piotrpodlaski/NixieClockPCB/nixie_adapter_pp/NX-SZP-IN3-v01.STEP

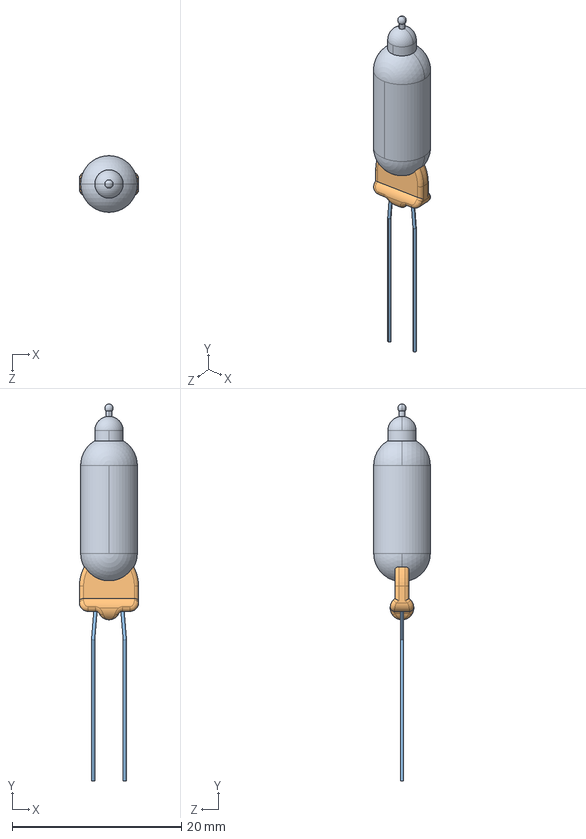
[picture p1: CAD file, 2023-03-22]
nixie_adapter_pp/NX-SZP-IN3-v01.STEP
7.00 x 44.6 x 6.70 mm
NX-SZP-IN3-01-v01
NX-SZP-IN3-02-v01 x 2
NX-SZP-IN3-03-v01
NX-SZP-IN3-04-v01
NX-SZP-IN3-05-v01
NX-SZP-IN3-06-v01
