piotrpodlaski/NixieClockPCB/nixie_controller/T491D107K020AT.step

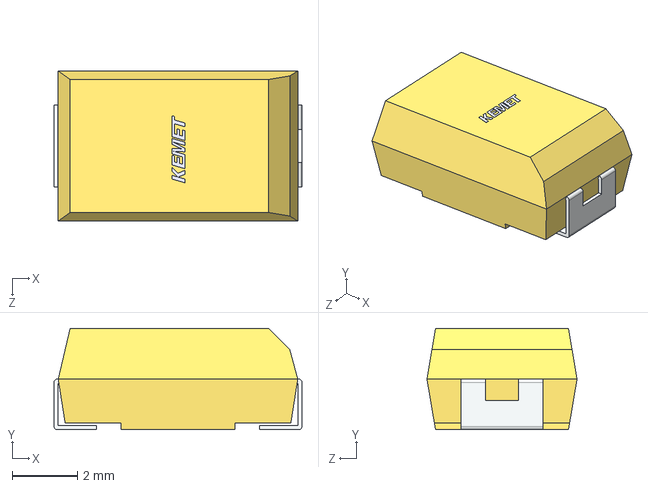
[picture p2: CAD file, 2023-03-22]
nixie_controller/T491D107K020AT.step
7.60 x 3.11 x 4.60 mm
