piotrpodlaski/NixieClockPCB/nixie_controller/SBC847BDW1T1G.step

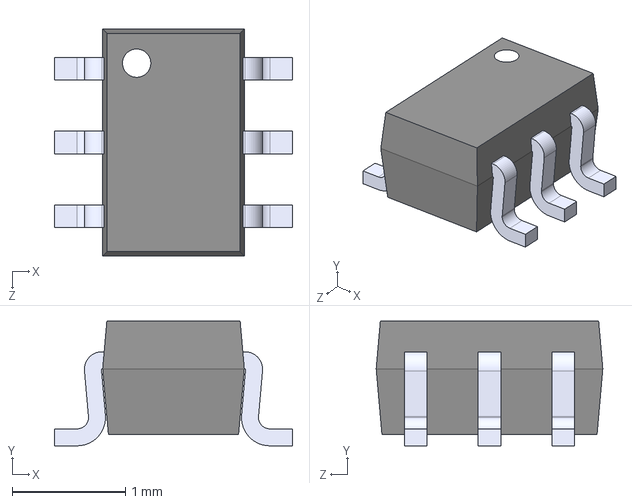
[picture p3: CAD file, 2023-03-22]
nixie_controller/SBC847BDW1T1G.step
2.10 x 1.10 x 2.00 mm
