piotrpodlaski/NixieClockPCB/nixie_controller/TYPE-C-31-M-12.step

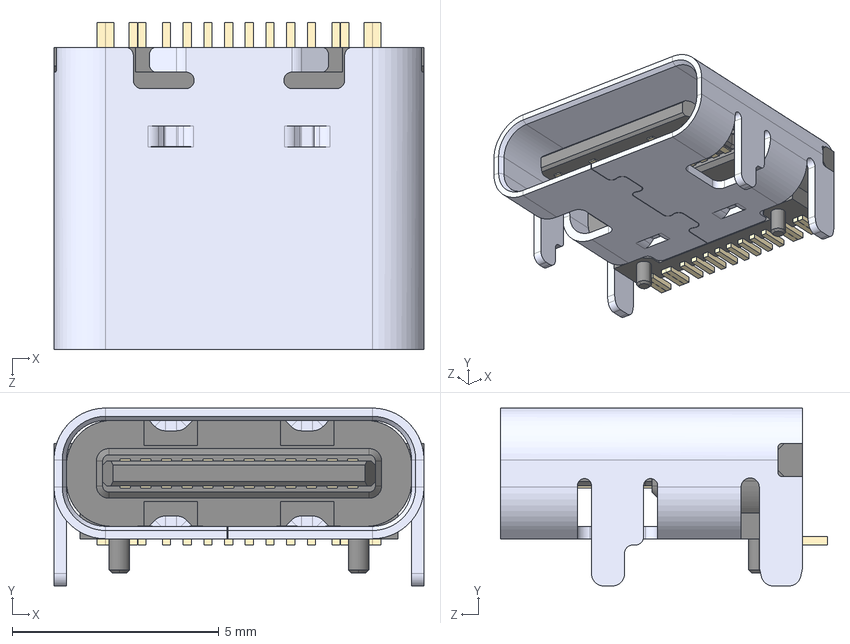
[picture p4: CAD file, 2023-03-22]
nixie_controller/TYPE-C-31-M-12.step
8.94 x 4.30 x 7.90 mm
