piotrpodlaski/NixieClockPCB/nixie_controller/SKRKAHE020--3DModel-STEP-56544.STEP

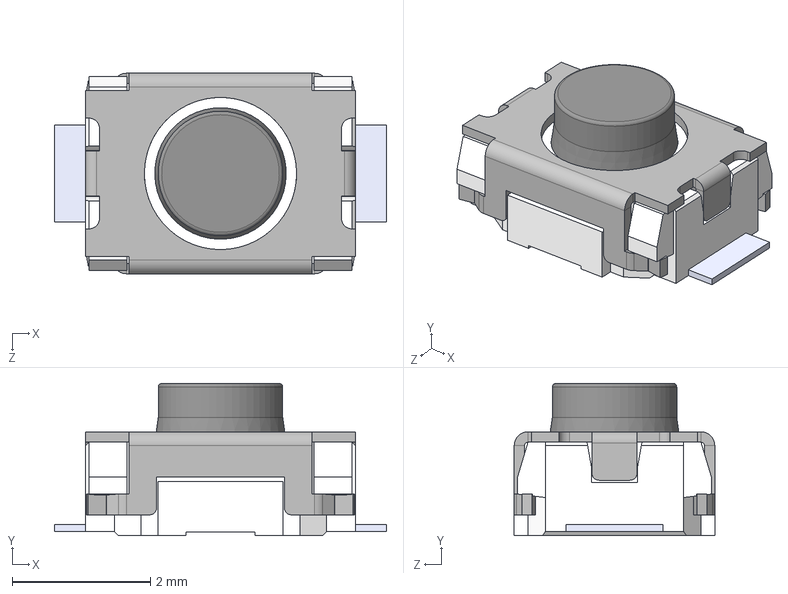
[picture p5: CAD file, 2023-03-22]
nixie_controller/SKRKAHE020--3DModel-STEP-56544.STEP
4.80 x 2.20 x 2.90 mm
