piotrpodlaski/NixieClockPCB/nixie_controller/TPIC6B595DW.step

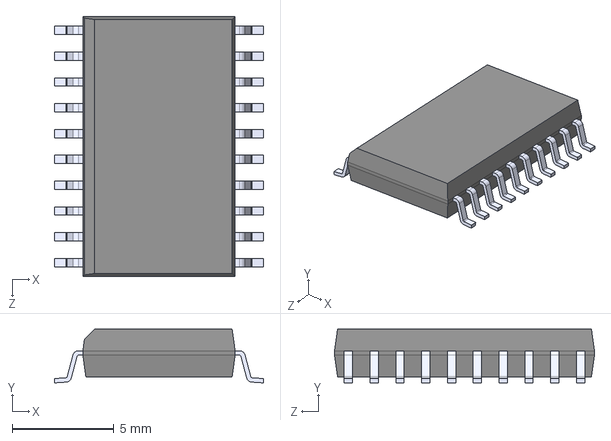
[picture p6: CAD file, 2023-03-22]
nixie_controller/TPIC6B595DW.step
10.3 x 2.65 x 12.8 mm
