piotrpodlaski/NixieClockPCB/nixie_controller/B82464G4153M000.STEP

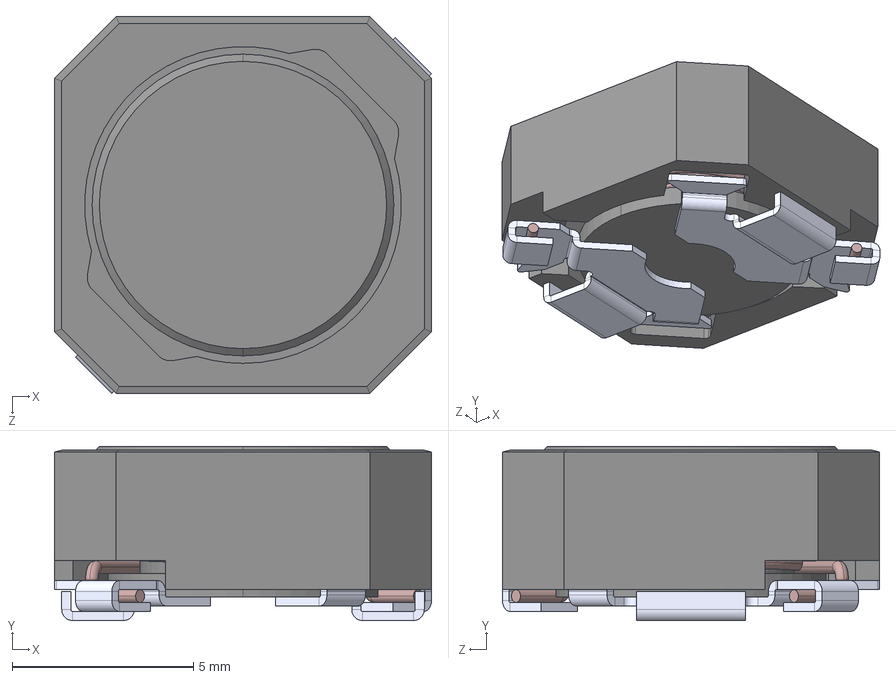
[picture p7: CAD file, 2023-03-22]
nixie_controller/B82464G4153M000.STEP
10.4 x 4.80 x 10.4 mm
