piotrpodlaski/NixieClockPCB/level_converter_fix.pdf

# Logic Level Converter Fix

# NixieClock

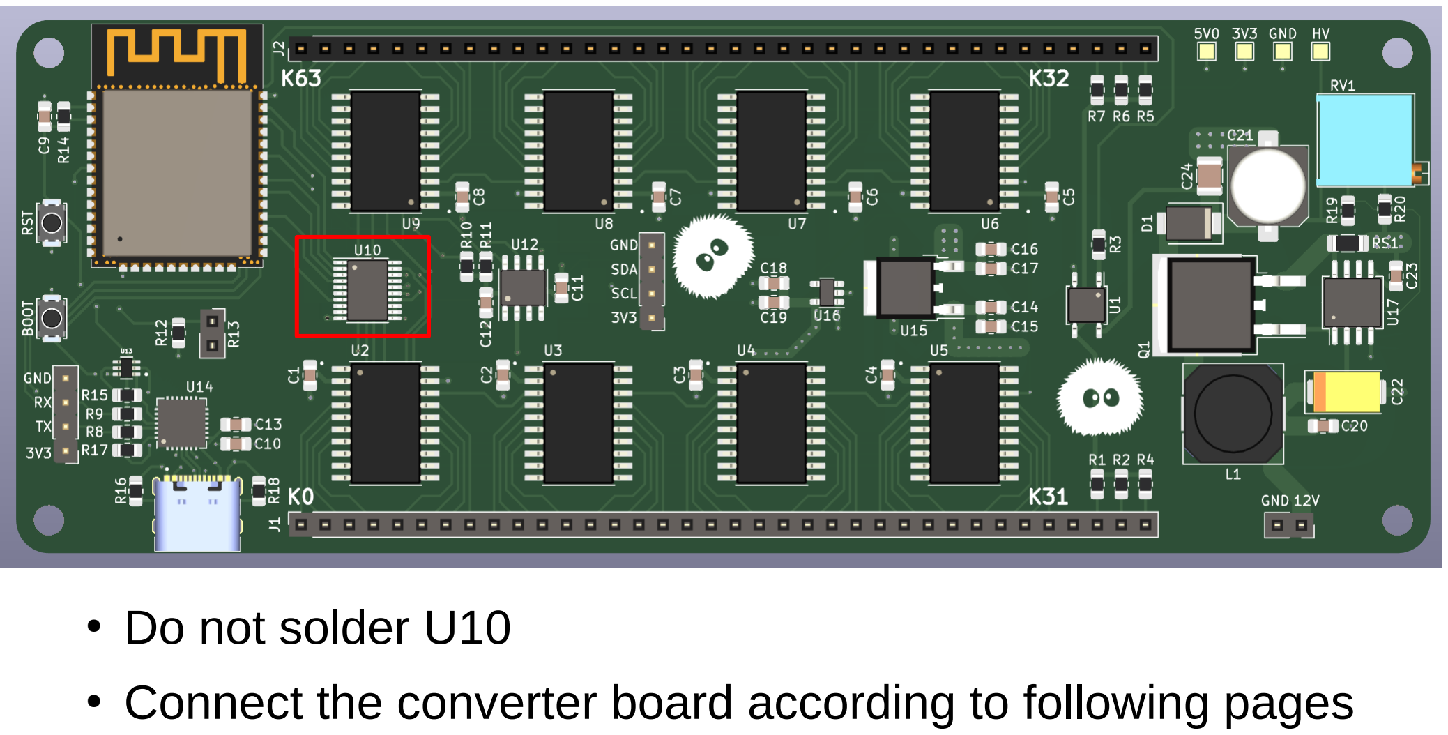
[picture p8: page 2]

## - Do not solder U10

## - Connect the converter board according to following pages

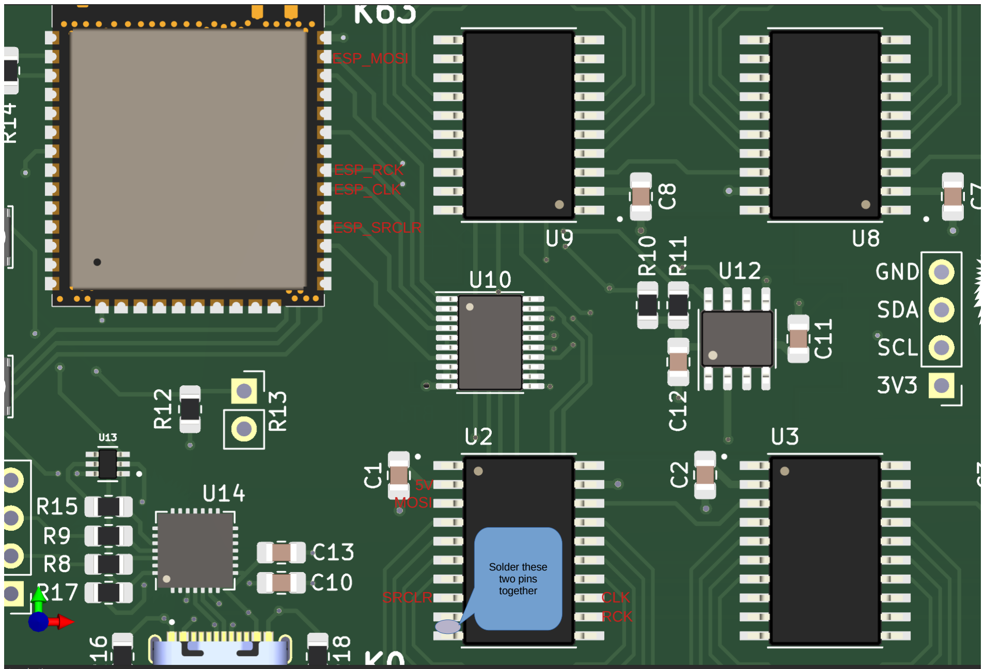
[picture p9: page 3]

ESP_MOSI

ESP_RCK

ESP_CLK

ESP_SRCLR

CLK

RCK

MOSI

SRCLR

5V

Solder these
two pins
together

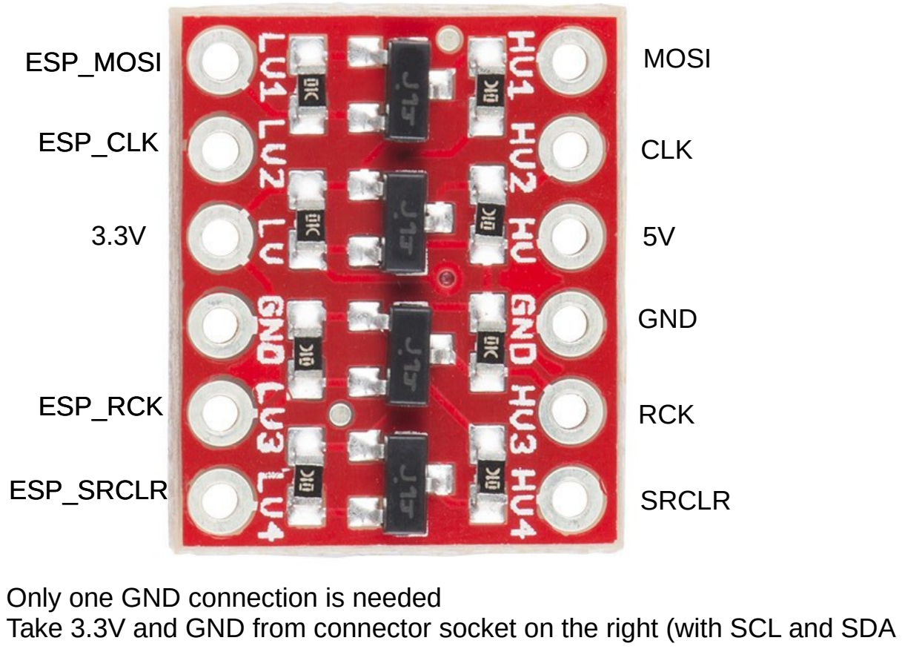
[picture p10: page 4]

ESP_MOSI

ESP_CLK

ESP_RCK

ESP_SRCLR

CLK

MOSI

RCK

SRCLR

3.3V

GND

Only one GND connection is needed
Take 3.3V and GND from connector socket on the right (with SCL and SDA

5V
