piotrpodlaski/NixieClockPCB/nixie_adapter_pp.pdf

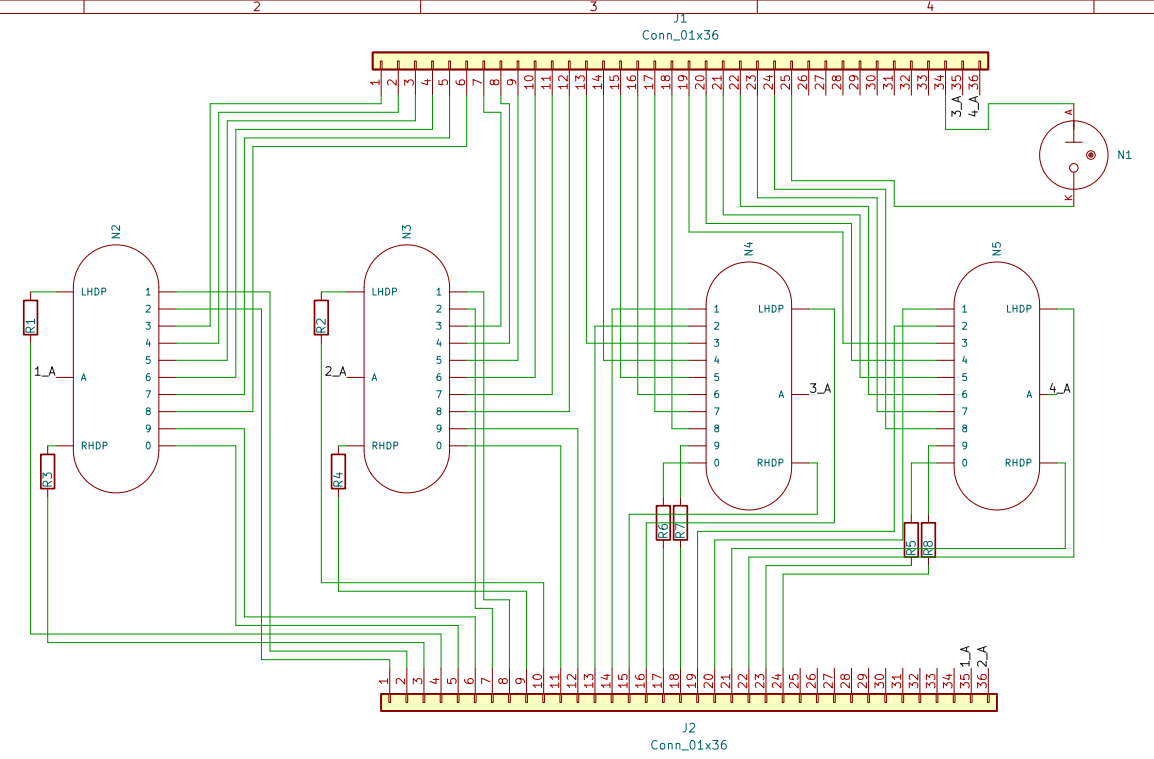
[picture p11: page 1]

Id: 1/1 Title: File: nixie_adapter_pp.kicad_sch Sheet: / R5
