piotrpodlaski/NixieClockPCB/nixie_controller.pdf

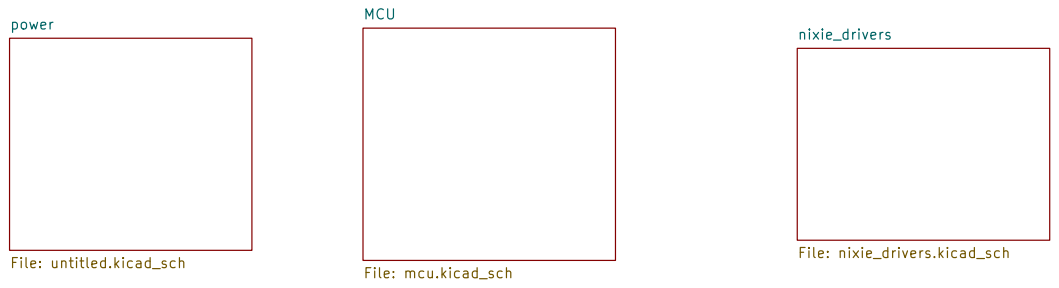
[picture p12: page 1]

Id: 1/4 Title: File: nixie_controller.kicad_sch Sheet: /

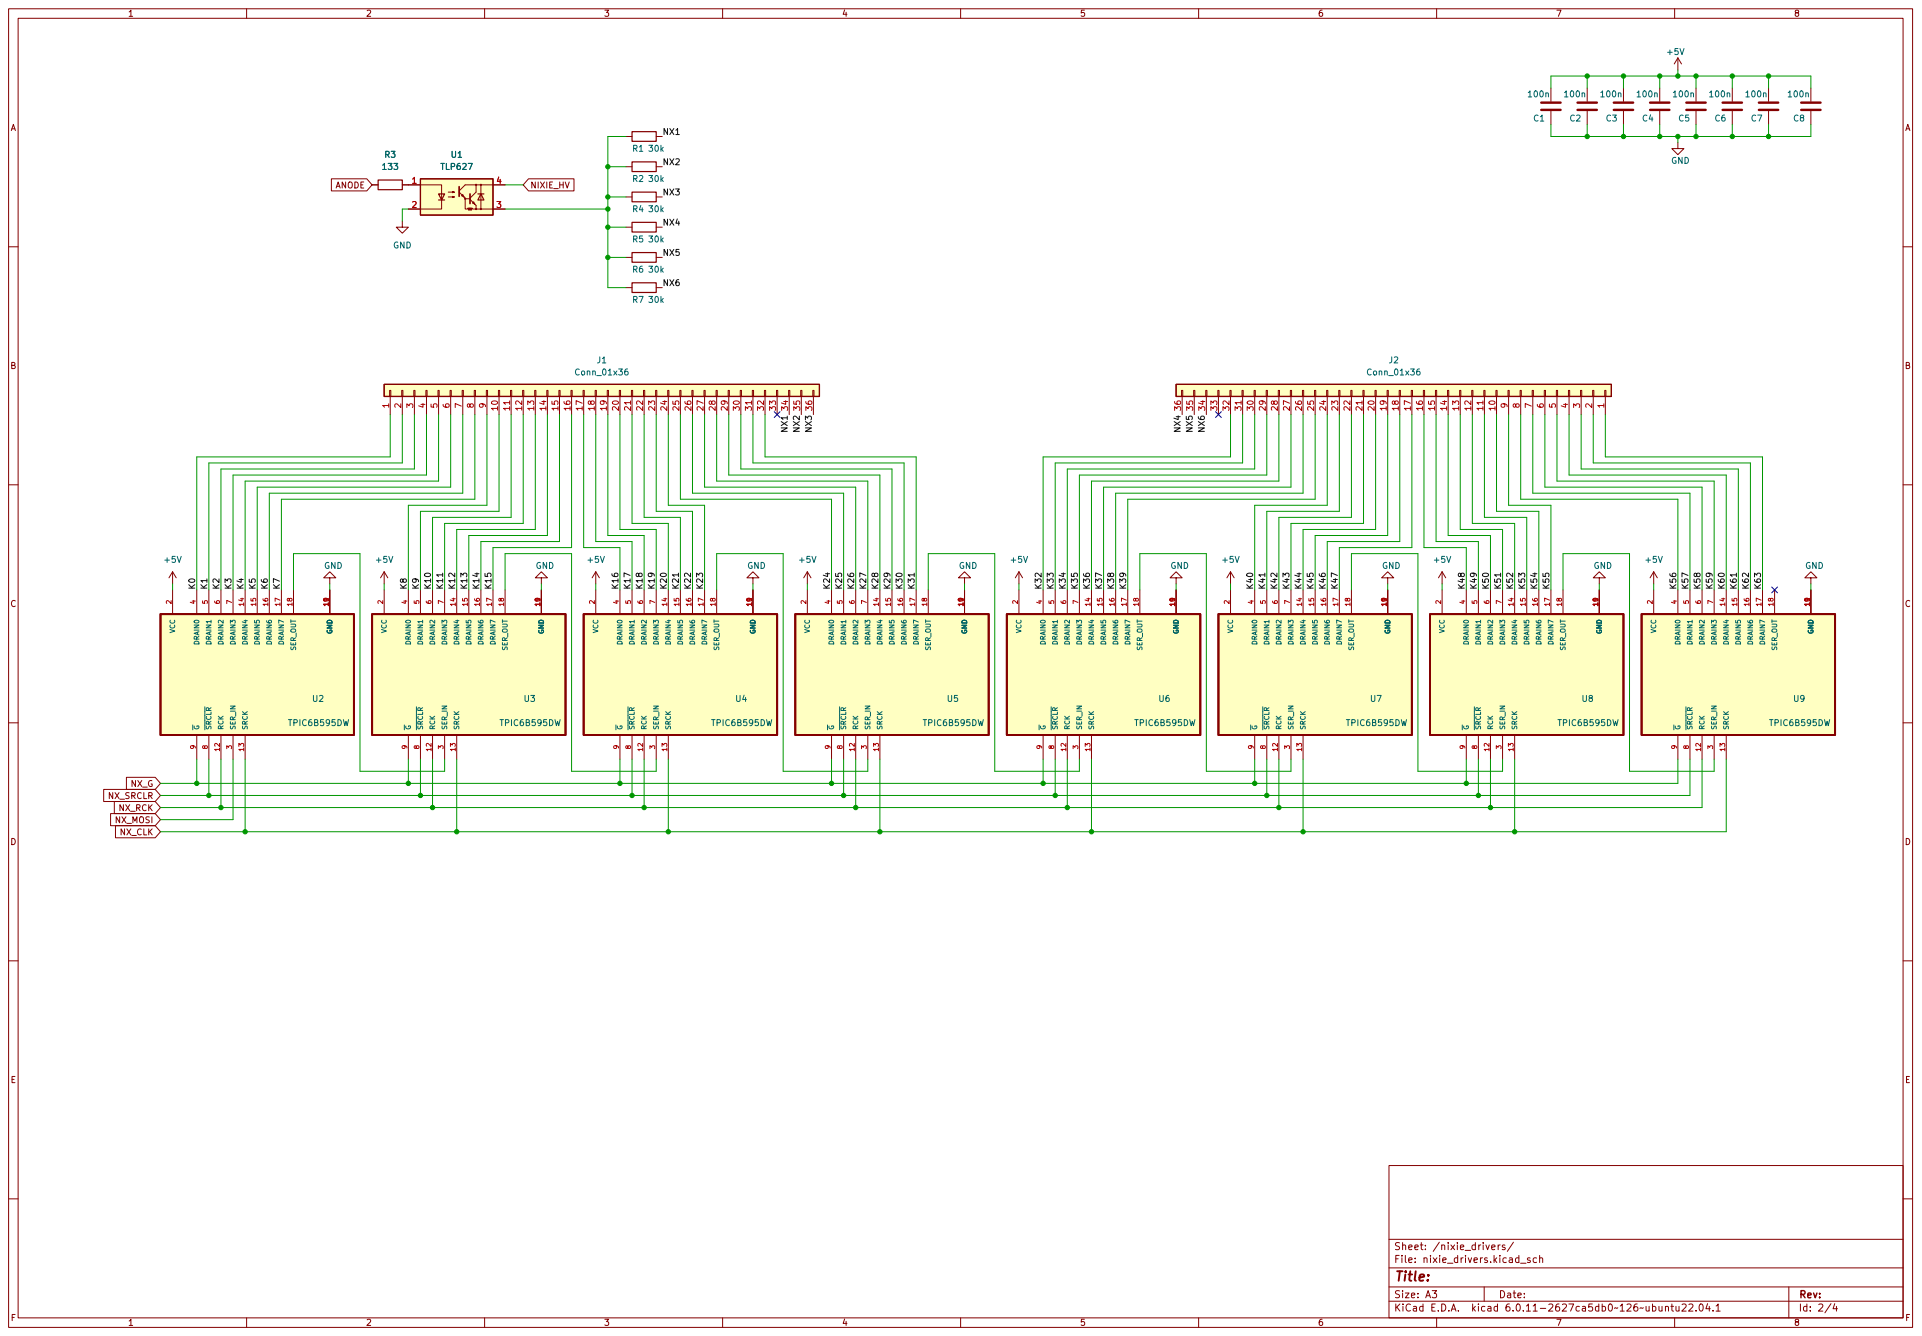
[picture p13: page 2]

7 ~{SRCLR} 8 ~{G} 9 U4 TPIC6B595DW GND 101 RCK 12 SRCK 13 DRAIN4 14 DRAIN5 15 DRAIN6 16 DRAIN7 17 SER_OUT 18 GND 19 VCC

Id: 2/4 Title: File: nixie_drivers.kicad_sch Sheet: /nixie_drivers/

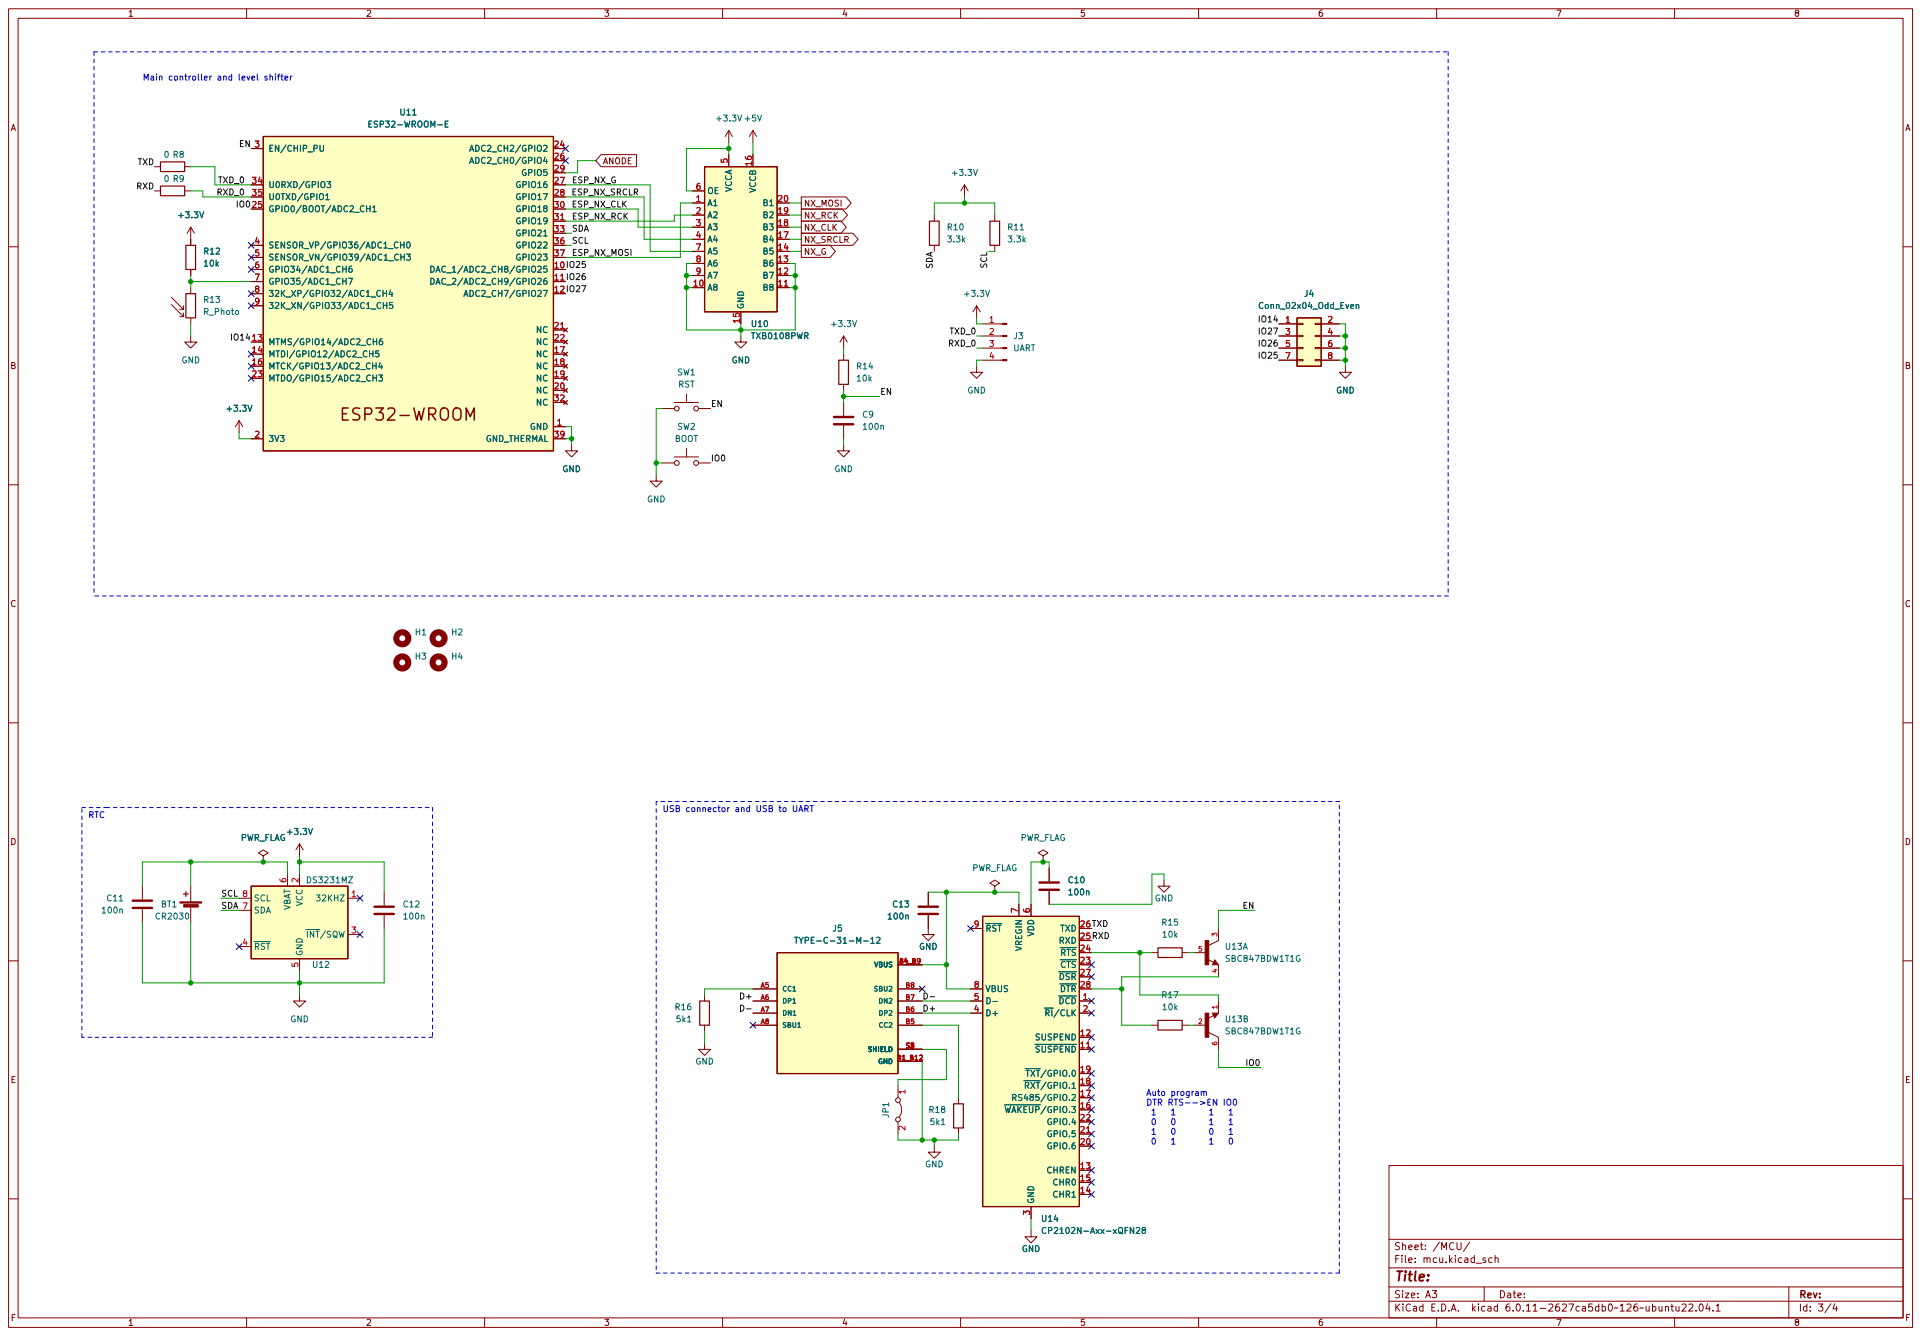
[picture p14: page 3]

Id: 3/4 Title: File: mcu.kicad_sch Sheet: /MCU/

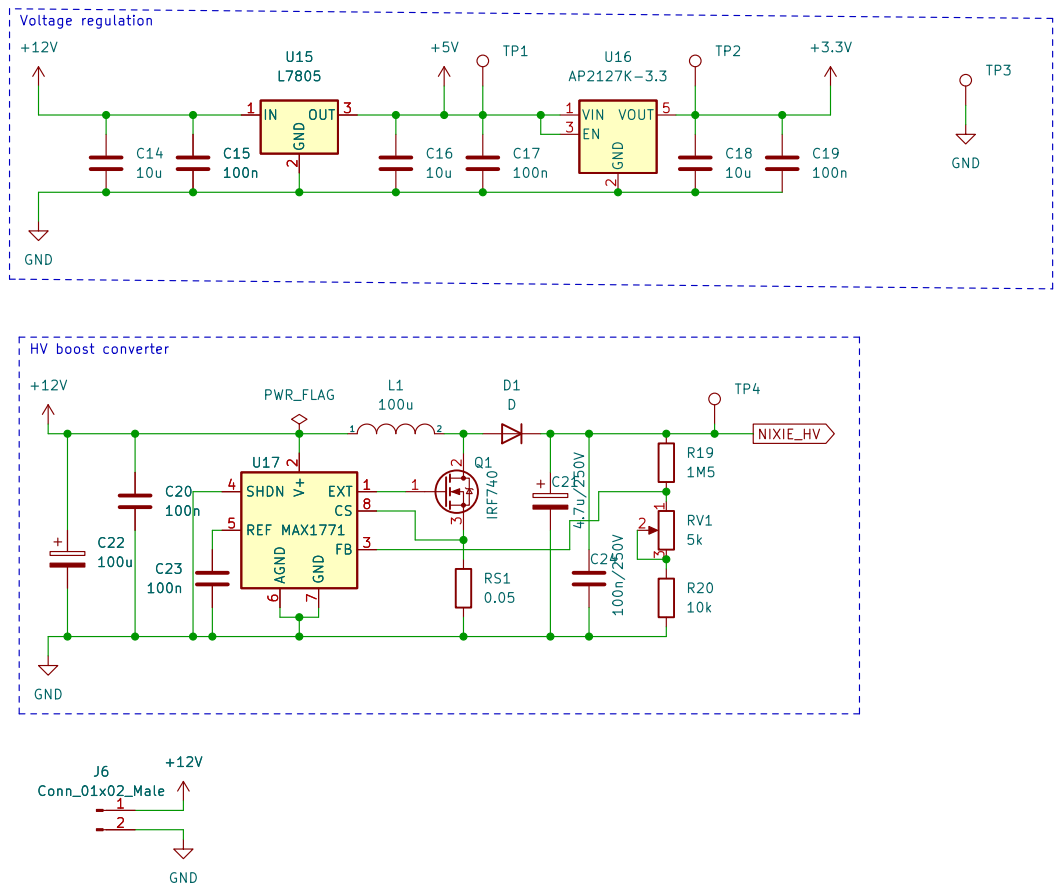
[picture p15: page 4]

Id: 4/4 Title: File: untitled.kicad_sch Sheet: /power/
