piotrpodlaski/NixieClockPCB/nixie_adapter_pp/nixie_adapter_pp.kicad_pcb

## KiCad design nixie_adapter_pp/nixie_adapter_pp.kicad_pcb (2023-03-22)

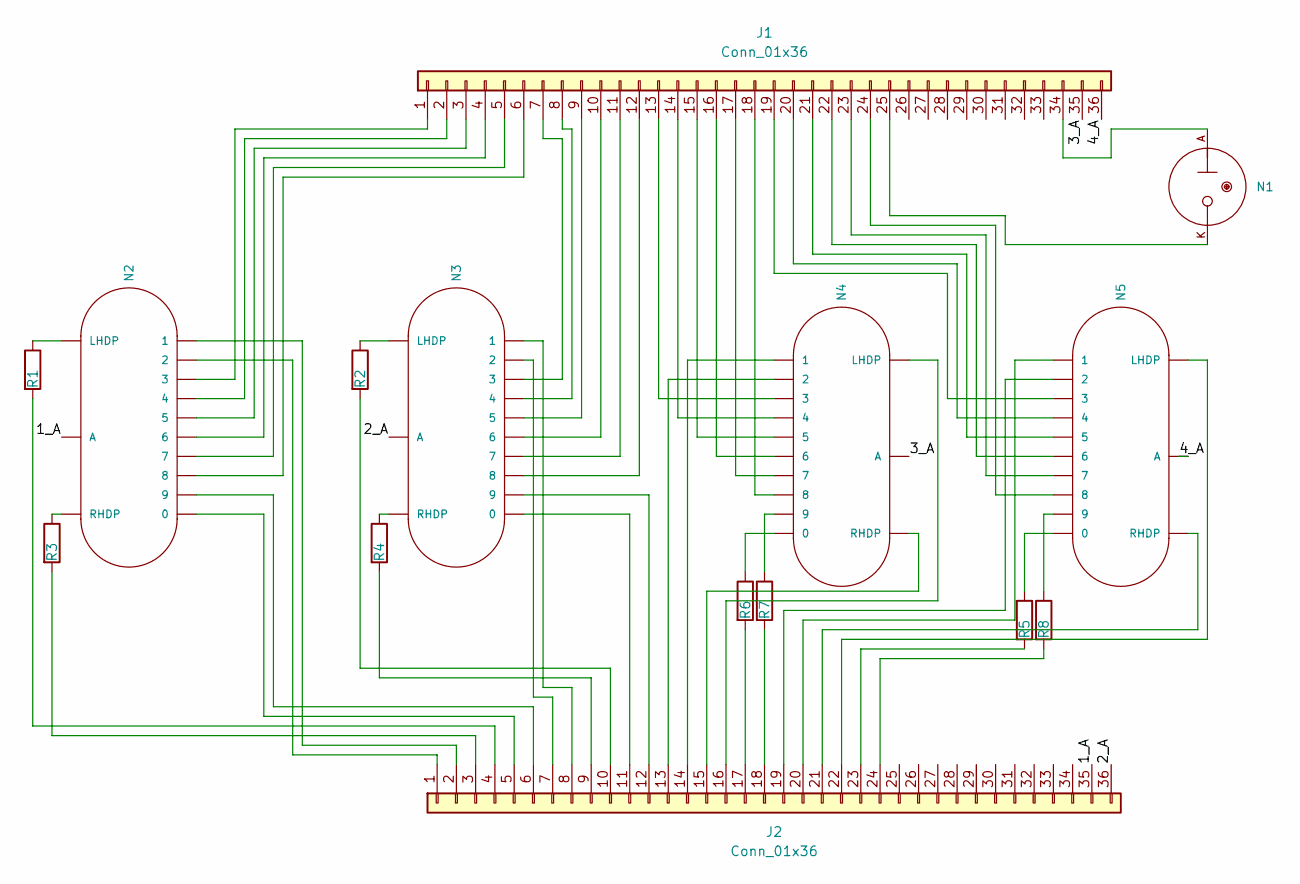
[picture p16: schematic nixie_adapter_pp.kicad_sch]

Parts:
J1, J2: Conn_01x36; PinHeader_1x36_P2.54mm_Vertical
N1: IN-3; nixies-us-IN-3
N2, N3, N4, N5: IN-14; nixies-us-IN-14
R1, R2, R3, R4, R5, R6, R7, R8: R; R_0805_2012Metric_Pad1.20x1.40mm_HandSolder

Connections:
/1_A: J2.35, N2.A
/2_A: J2.36, N3.A
/3_A: J1.35, N4.A
/4_A: J1.36, N5.A
unnamed: J1.1, N2.8 (3)
unnamed: J1.2, N2.7 (4)
unnamed: J1.3, N2.6 (5)
unnamed: J1.4, N2.5 (6)
unnamed: J1.5, N2.4 (7)
unnamed: J1.6, N2.3 (8)
unnamed: J1.7, N3.8 (3)
unnamed: J1.8, N3.7 (4)
unnamed: J1.9, N3.6 (5)
unnamed: J1.10, N3.5 (6)
unnamed: J1.13, N4.8 (3)
unnamed: J1.14, N4.7 (4)
unnamed: J1.15, N4.6 (5)
unnamed: J1.16, N4.5 (6)
unnamed: J1.17, N4.4 (7)
unnamed: J1.18, N4.3 (8)
unnamed: J1.19, N5.8 (3)
unnamed: J1.20, N5.7 (4)
unnamed: J1.21, N5.6 (5)
unnamed: J1.22, N5.5 (6)
unnamed: J1.23, N5.4 (7)
unnamed: J1.24, N5.3 (8)
unnamed: J1.25, N1.K
unnamed: J1.34, N1.A
unnamed: J2.1, N2.9 (2)
unnamed: J2.2, N2.0 (1)
unnamed: J2.3, R3.2
unnamed: J2.4, R1.2
unnamed: J2.5, N2.1 (0)
unnamed: J2.6, N2.2 (9)
unnamed: J2.7, N3.9 (2)
unnamed: J2.9, R4.2
unnamed: J2.10, R2.2
unnamed: J2.13, N4.9 (2)
unnamed: J2.14, N4.0 (1)
unnamed: J2.15, N4.RHDP
unnamed: J2.16, N4.LHDP
unnamed: J2.17, R6.2
unnamed: J2.18, R7.2
unnamed: J2.19, N5.9 (2)
unnamed: J2.20, N5.0 (1)
unnamed: J2.21, N5.RHDP
unnamed: J2.23, R5.2
unnamed: J2.24, R8.2
unnamed: N2.LHDP, R1.1
unnamed: N2.RHDP, R3.1
unnamed: J2.8, N3.0 (1)
unnamed: J2.11, N3.1 (0)
unnamed: J2.12, N3.2 (9)
unnamed: J1.12, N3.3 (8)
unnamed: J1.11, N3.4 (7)
unnamed: N3.LHDP, R2.1
unnamed: N3.RHDP, R4.1
unnamed: N4.1 (0), R6.1
unnamed: N4.2 (9), R7.1
unnamed: N5.2 (9), R8.1
unnamed: J2.22, N5.LHDP
unnamed: N5.1 (0), R5.1

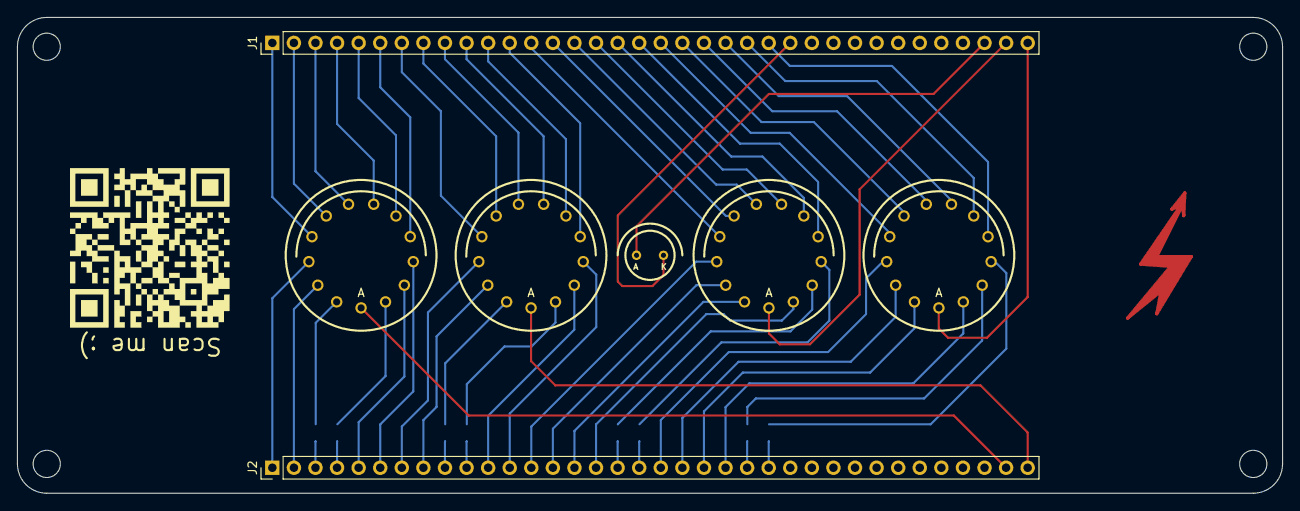
[picture p17: board nixie_adapter_pp.kicad_pcb from above]

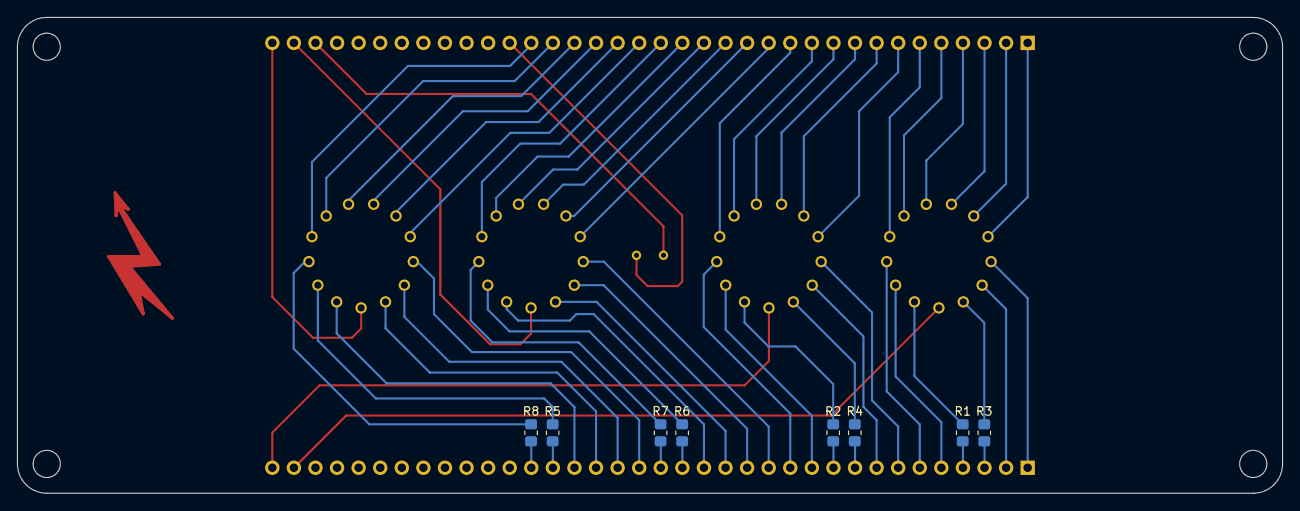
[picture p18: board nixie_adapter_pp.kicad_pcb from below]

Board: 2 copper layers, 148.9 x 56.0 mm, 19 parts (8 on the bottom side), 62 nets.

Other parts of the board:
H1, H2, H3, H4: MountingHole; MountingHole_3.2mm_M3
