piotrpodlaski/NixieClockPCB/nixie_controller/nixie_controller.kicad_pcb

## KiCad design nixie_controller/nixie_controller.kicad_pcb (2023-03-22)

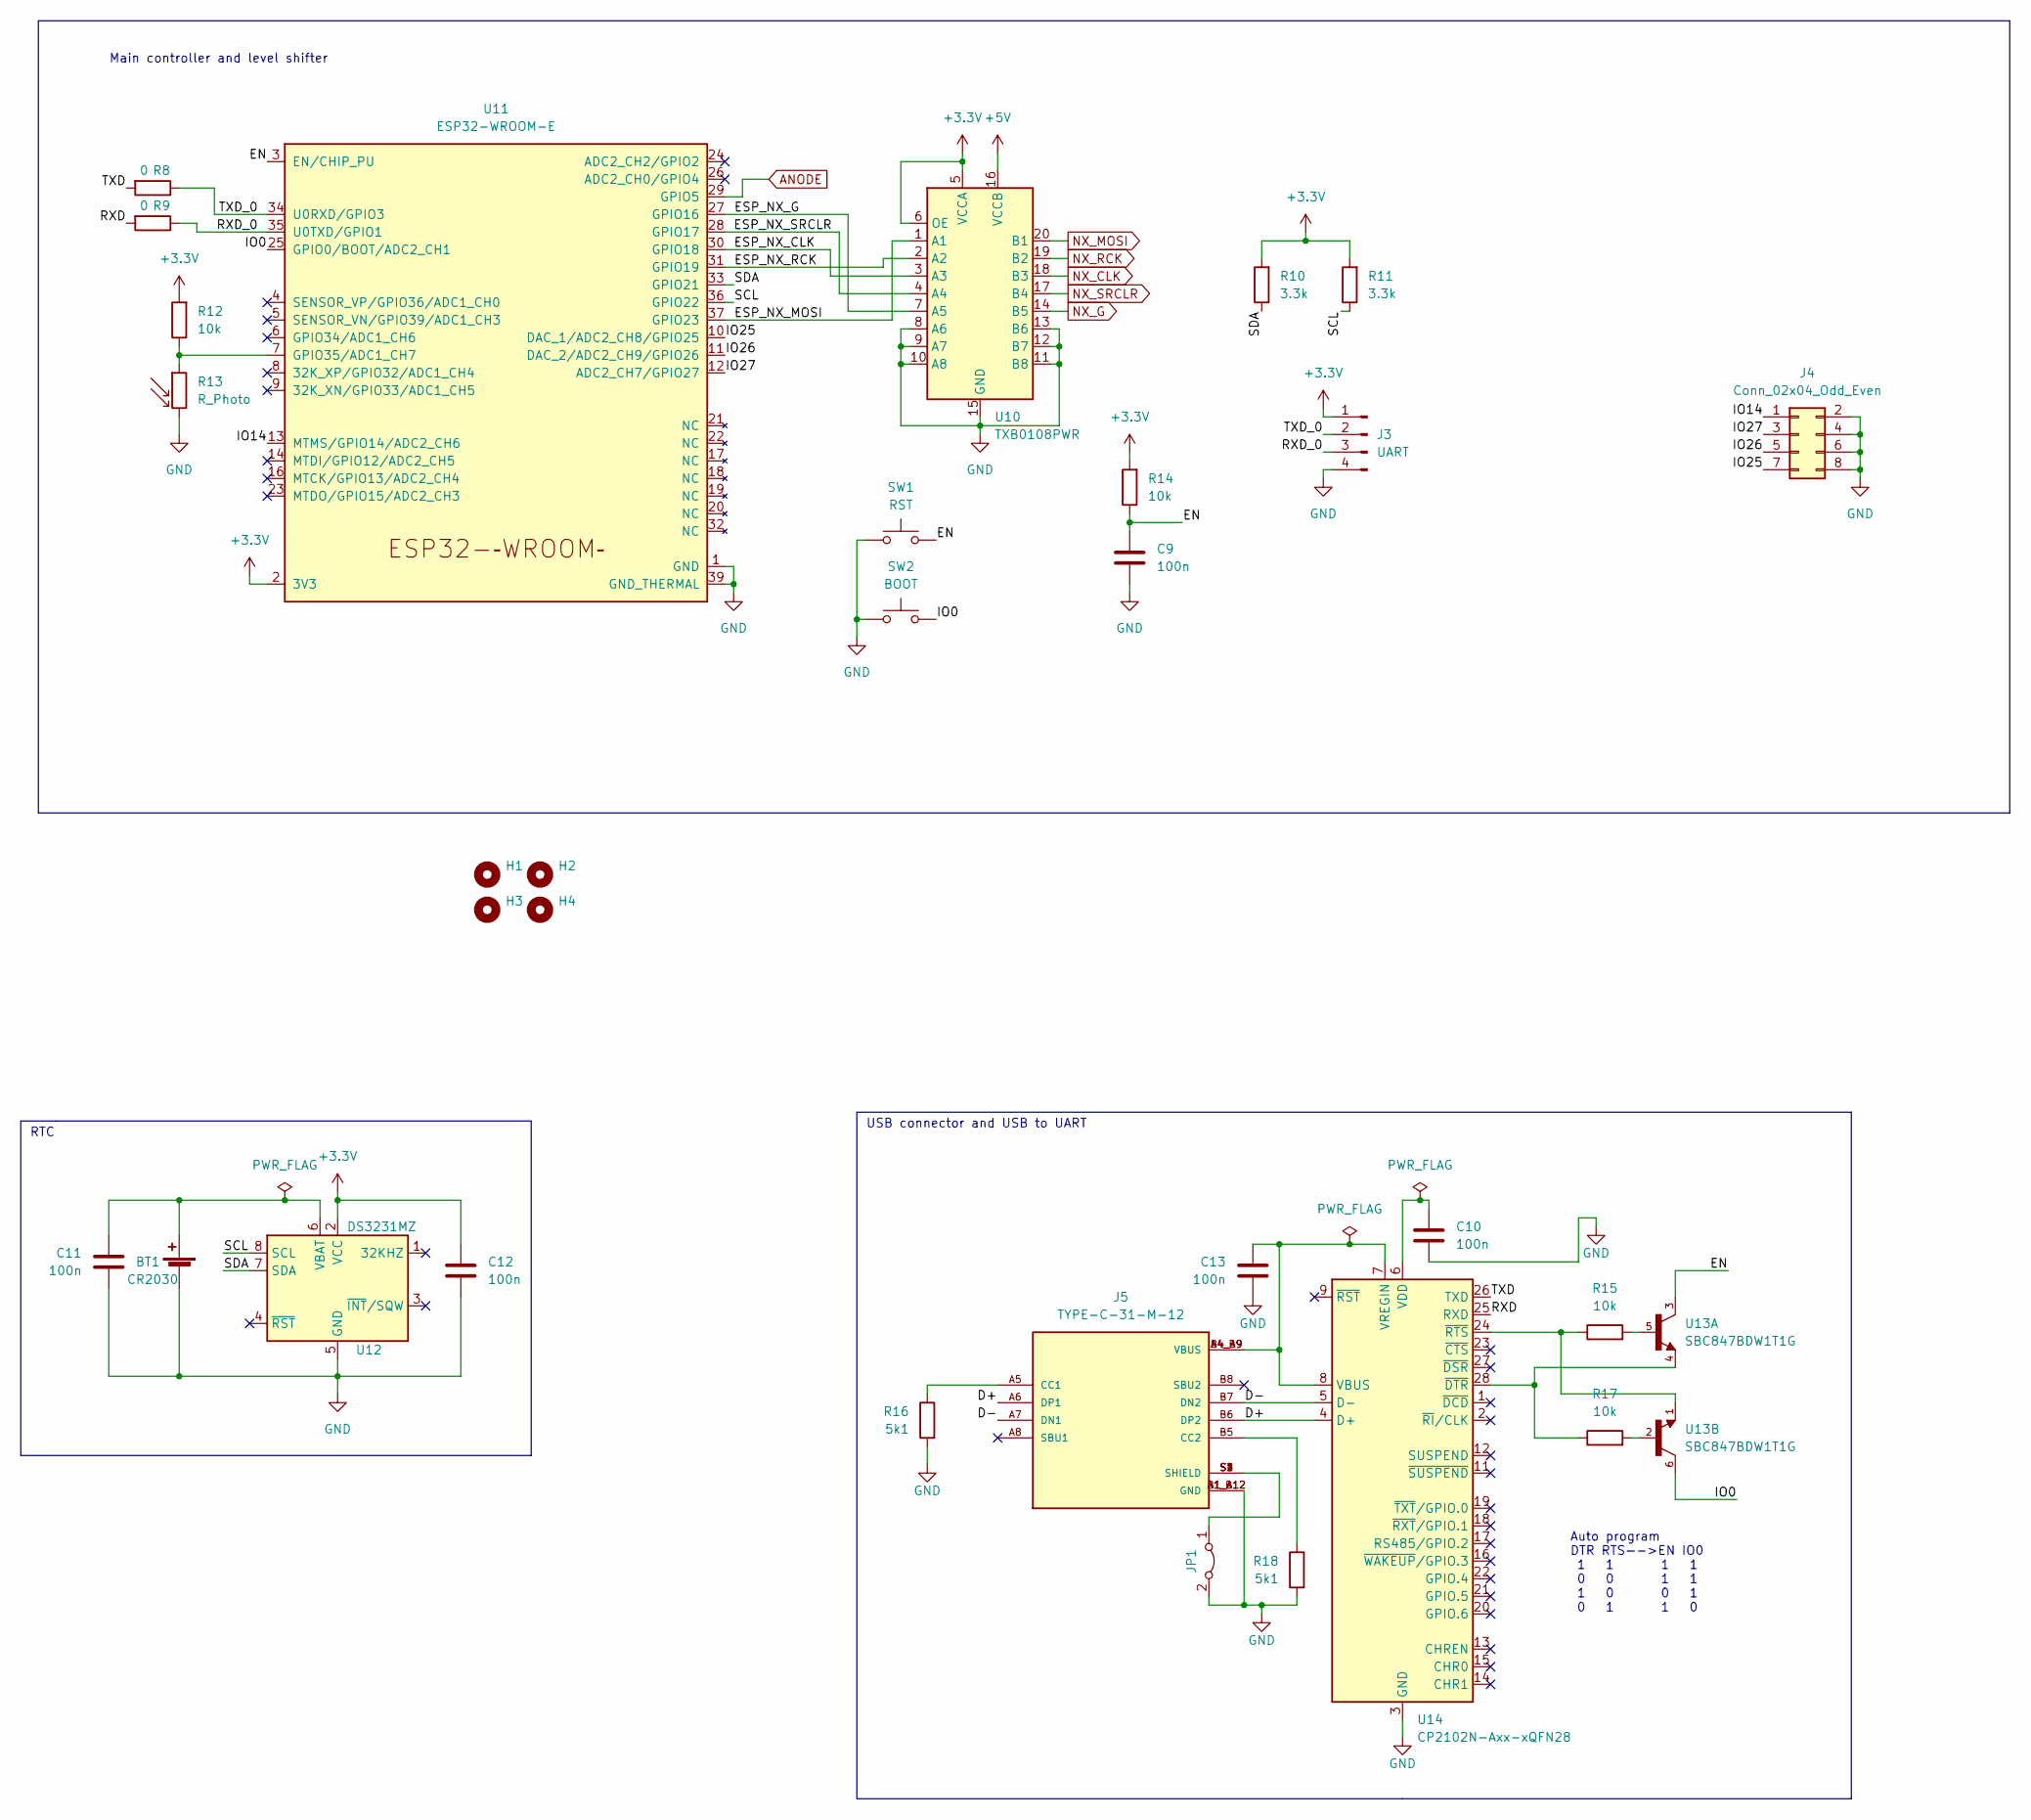
[picture p19: schematic mcu.kicad_sch]

Parts:
BT1: CR2030; BatteryHolder_Keystone_1060_1x2032; LCSC C238069
C9, C10, C11, C12, C13: 100n; C_0805_2012Metric_Pad1.18x1.45mm_HandSolder; LCSC C396718
H1, H2, H3, H4: MountingHole; MountingHole_3.2mm_M3; LCSC NOPLACE
J3: UART; PinHeader_1x04_P2.54mm_Vertical; LCSC NOPLACE
J4: Conn_02x04_Odd_Even; PinHeader_2x04_P2.00mm_Vertical_SMD; LCSC NOPLACE
J5: TYPE-C-31-M-12; HRO_TYPE-C-31-M-12; PARTREV 2020.12.08; LCSC C165948
JP1: Jumper_2_Bridged; SolderJumper-2_P1.3mm_Bridged_Pad1.0x1.5mm; LCSC NOPLACE
R8, R9: 0; R_0805_2012Metric_Pad1.20x1.40mm_HandSolder; LCSC C17477
R10, R11: 3.3k; R_0805_2012Metric_Pad1.20x1.40mm_HandSolder; LCSC C26010
R12, R14, R15, R17: 10k; R_0805_2012Metric_Pad1.20x1.40mm_HandSolder; LCSC C17414
R13: R_Photo; PinSocket_1x02_P2.54mm_Vertical; LCSC C125627
R16, R18: 5k1; R_0805_2012Metric_Pad1.20x1.40mm_HandSolder; LCSC C269748
SW1: RST; SW_Push_SPST_NO_Alps_SKRK; LCSC C202388
SW2: BOOT; SW_Push_SPST_NO_Alps_SKRK; LCSC C202388
U10: TXB0108PWR; TSSOP-20_4.4x6.5mm_P0.65mm; LCSC C53406
U11: ESP32-WROOM-E; ESP32-WROOM-32E; LCSC C473012
U12: DS3231MZ; SOIC-8_3.9x4.9mm_P1.27mm; LCSC C107410
U13: SBC847BDW1T1G; SOT65P210X110-6N; LCSC C232475
U14: CP2102N-Axx-xQFN28; QFN-28-1EP_5x5mm_P0.5mm_EP3.35x3.35mm; LCSC C6568

Connections:
+5V: U10.16 (VCCB); also elsewhere on the board
/MCU/D+: J5.A6 (DP1), J5.B6 (DP2), U14.4 (D+)
/MCU/D-: J5.A7 (DN1), J5.B7 (DN2), U14.5 (D-)
/MCU/EN: C9.2, R14.1, SW1.2, U11.3 (EN/CHIP_PU), U13.3
/MCU/ESP_NX_CLK: U10.3 (A3), U11.30 (GPIO18)
/MCU/ESP_NX_G: U10.7 (A5), U11.27 (GPIO16)
/MCU/ESP_NX_MOSI: U10.1 (A1), U11.37 (GPIO23)
/MCU/ESP_NX_RCK: U10.2 (A2), U11.31 (GPIO19)
/MCU/ESP_NX_SRCLR: U10.4 (A4), U11.28 (GPIO17)
/MCU/IO0: SW2.2, U11.25 (GPIO0/BOOT/ADC2_CH1), U13.6
/MCU/IO25: J4.7, U11.10 (DAC_1/ADC2_CH8/GPIO25); also elsewhere on the board
/MCU/IO26: J4.5, U11.11 (DAC_2/ADC2_CH9/GPIO26); also elsewhere on the board
/MCU/RXD: R9.2, U14.25 (RXD)
/MCU/RXD_0: J3.3, R9.1, U11.35 (U0TXD/GPIO1)
/MCU/TXD: R8.2, U14.26 (TXD)
/MCU/TXD_0: J3.2, R8.1, U11.34 (U0RXD/GPIO3)
ANODE: U11.29 (GPIO5); also elsewhere on the board
NX_CLK: U10.18 (B3); also elsewhere on the board
NX_G: U10.14 (B5); also elsewhere on the board
NX_MOSI: U10.20 (B1); also elsewhere on the board
NX_RCK: U10.19 (B2); also elsewhere on the board
NX_SRCLR: U10.17 (B4); also elsewhere on the board
unnamed: BT1.1 (+), C11.2, U12.6 (VBAT)
unnamed: C10.2, U14.6 (VDD)
unnamed: C13.2, J5.A4_B9 (VBUS), J5.B4_A9 (VBUS), U14.7 (VREGIN), U14.8 (VBUS)
unnamed: J5.A5 (CC1), R16.1
unnamed: J5.B5 (CC2), R18.1
unnamed: J5.S1 (SHIELD), J5.S2 (SHIELD), J5.S3 (SHIELD), J5.S4 (SHIELD), JP1.1 (A)
unnamed: R12.1, R13.1, U11.7 (GPIO35/ADC1_CH7)
unnamed: R15.1, U13.1, U14.24 (~RTS)
unnamed: R15.2, U13.5
unnamed: R17.1, U13.4, U14.28 (~DTR)
unnamed: R17.2, U13.2

Notes on the sheet:
Auto program DTR RTS-->EN IO0 1 1 1 1 0 0 1 1 1 0 0 1 0 1 1 0
Main controller and level shifter
RTC
USB connector and USB to UART

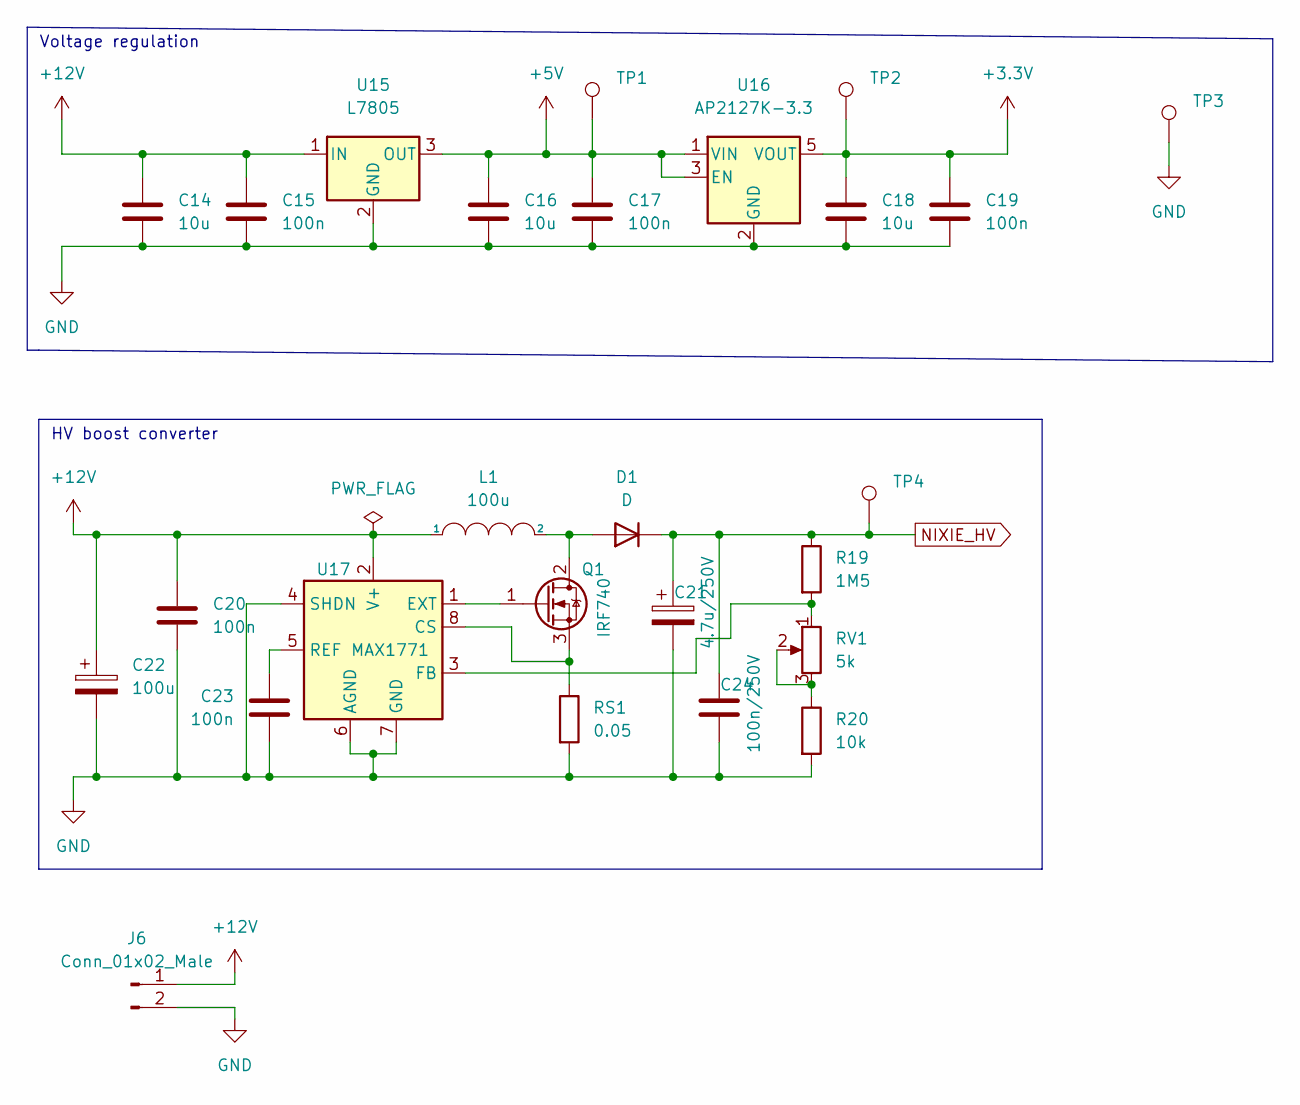
[picture p20: schematic untitled.kicad_sch]

Parts:
C14, C16, C18: 10u; C_0805_2012Metric_Pad1.18x1.45mm_HandSolder; LCSC C1713
C15, C17, C19, C20, C23: 100n; C_0805_2012Metric_Pad1.18x1.45mm_HandSolder; LCSC C396718
C21: 4.7u/250V; C_Elec_8x10.2; LCSC C88702
C22: 100u; CP_EIA-7343-15_Kemet-W; LCSC C122302
C24: 100n/250V; C_1210_3225Metric; LCSC C52020
D1: D; D_SMB; LCSC C145321
J6: Conn_01x02_Male; PinSocket_1x02_P2.54mm_Vertical; LCSC NOPLACE
L1: 100u; L_10.4x10.4_H4.8; LCSC C2962892
Q1: IRF740; TO-263-2; LCSC C39238
R19: 1M5; R_0805_2012Metric_Pad1.20x1.40mm_HandSolder; LCSC C137463
R20: 10k; R_0805_2012Metric_Pad1.20x1.40mm_HandSolder; LCSC C17414
RS1: 0.05; R_1206_3216Metric_Pad1.30x1.75mm_HandSolder; LCSC C149662
RV1: 5k; Potentiometer_Bourns_3296P_Horizontal; LCSC C780227
TP1: 5V0; TestPoint_Pad_1.5x1.5mm; LCSC NOPLACE
TP2: 3V3; TestPoint_Pad_1.5x1.5mm; LCSC NOPLACE
TP3: GND; TestPoint_Pad_1.5x1.5mm; LCSC NOPLACE
TP4: HV; TestPoint_Pad_1.5x1.5mm; LCSC NOPLACE
U15: L7805; TO-252-2; LCSC C310413
U16: AP2127K-3.3; SOT-23-5; LCSC C156285
U17: MAX1771; SO-8_5.3x6.2mm_P1.27mm; LCSC C407903

Connections:
+5V: C16.2, C17.2, TP1.1, U15.3 (OUT), U16.1 (VIN), U16.3 (EN); also elsewhere on the board
+12V: C14.2, C15.2, C20.1, C22.1, J6.1, L1.1, U15.1 (IN), U17.2 (V+)
NIXIE_HV: C21.1, C24.1, D1.1 (K), R19.1, TP4.1; also elsewhere on the board
unnamed: C23.2, U17.5 (REF)
unnamed: D1.2 (A), L1.2, Q1.2 (D)
unnamed: Q1.1 (G), U17.1 (EXT)
unnamed: Q1.3 (S), RS1.1, U17.8 (CS)
unnamed: R19.2, RV1.1, U17.3 (FB)
unnamed: R20.1, RV1.2, RV1.3

Notes on the sheet:
Voltage regulation
HV boost converter

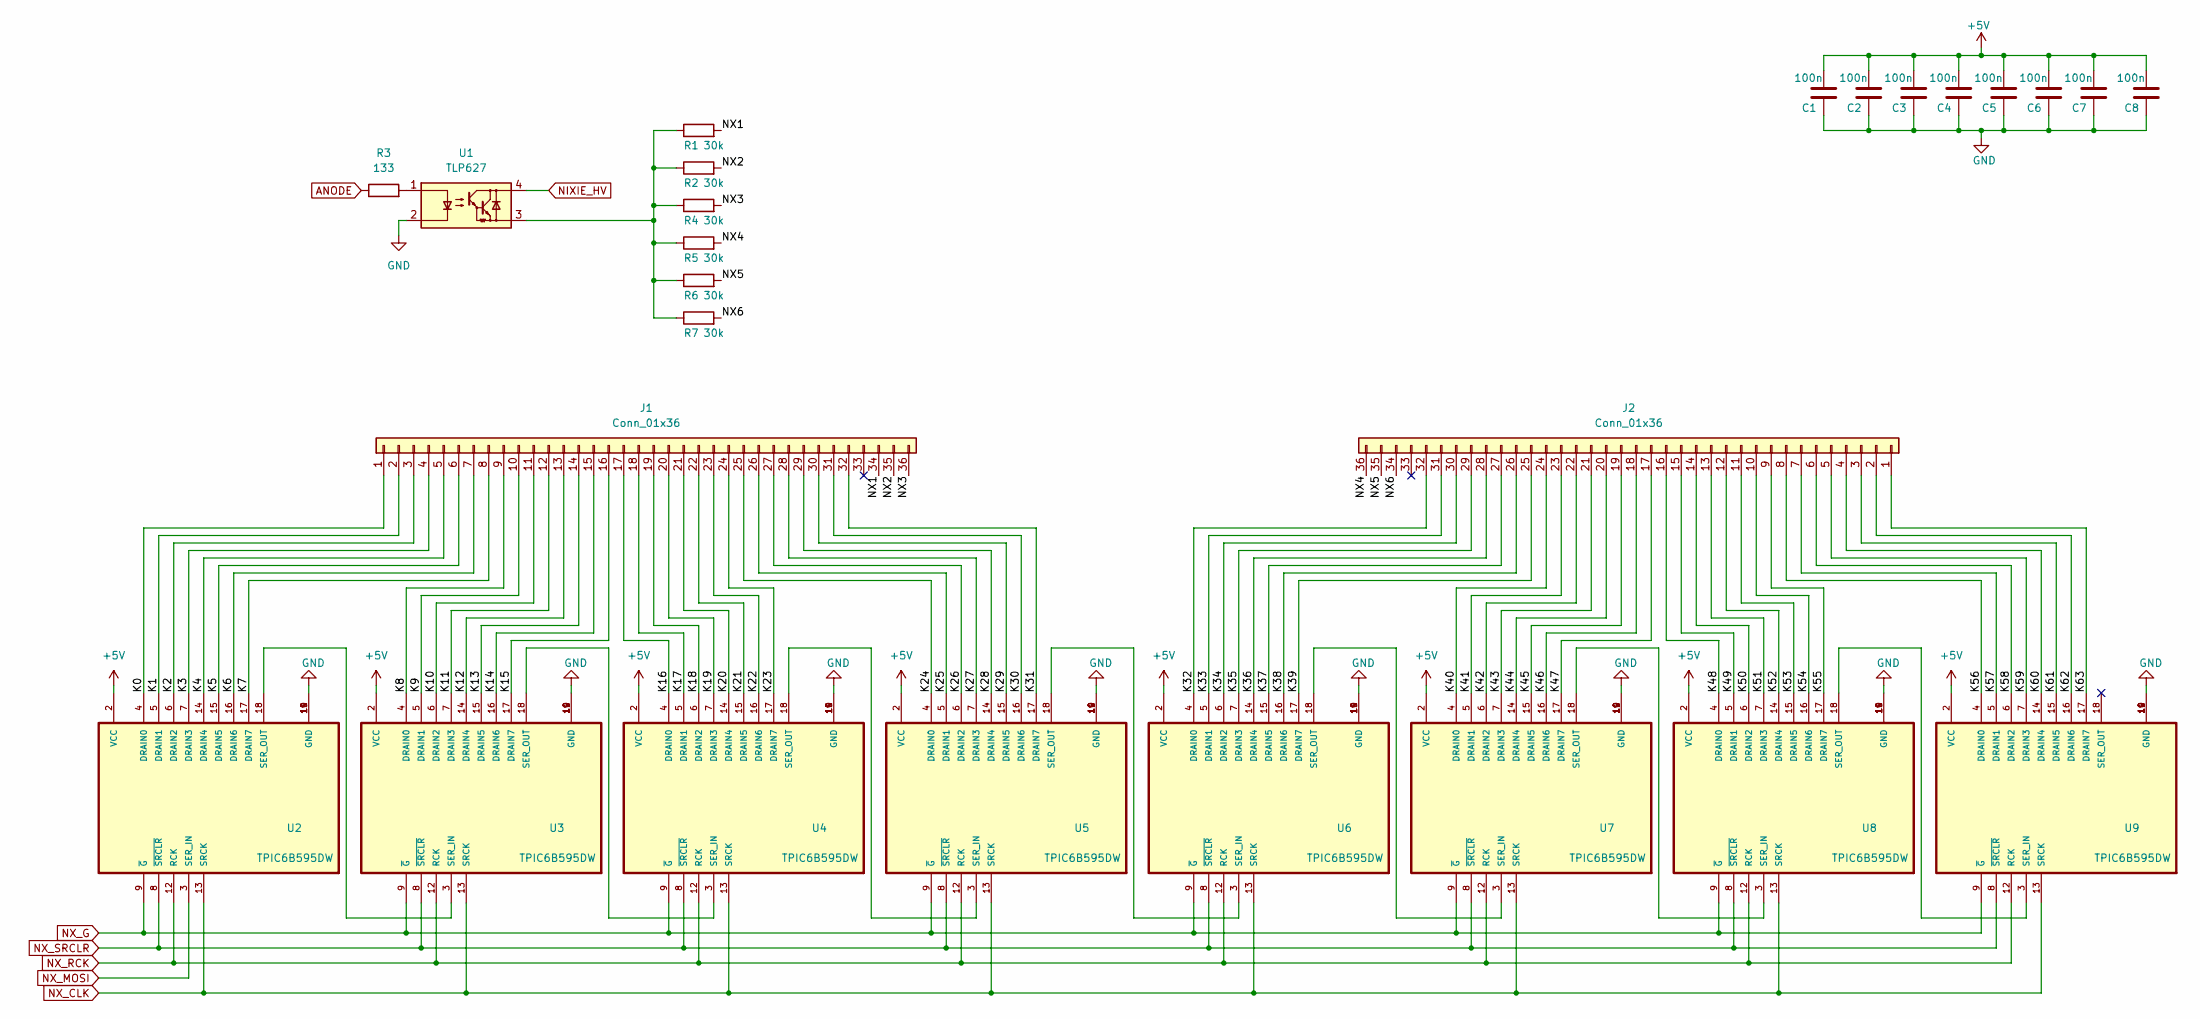
[picture p21: schematic nixie_drivers.kicad_sch]

Parts:
C1, C2, C3, C4, C5, C6, C7, C8: 100n; C_0805_2012Metric_Pad1.18x1.45mm_HandSolder; LCSC C396718
J1: Conn_01x36; PinSocket_1x36_P2.54mm_Vertical; LCSC NOPLACE
J2: Conn_01x36; PinHeader_1x36_P2.54mm_Vertical; LCSC NOPLACE
R1, R2, R4, R5, R6, R7: 30k; R_0805_2012Metric_Pad1.20x1.40mm_HandSolder; LCSC C17621
R3: 133; R_0805_2012Metric_Pad1.20x1.40mm_HandSolder; LCSC C2828762
U1: TLP627; SOP-4_3.8x4.1mm_P2.54mm; LCSC C30336
U2, U3, U4, U5, U6, U7, U8, U9: TPIC6B595DW; SOIC127P1030X265-20N; LCSC C7094

Connections:
+5V: C1.2, C2.2, C3.2, C4.2, C5.2, C6.2, C7.2, C8.2, U2.2 (VCC), U3.2 (VCC), U4.2 (VCC), U5.2 (VCC), U6.2 (VCC), U7.2 (VCC), U8.2 (VCC), U9.2 (VCC); also elsewhere on the board
/nixie_drivers/K0: J1.1, U2.4 (DRAIN0)
/nixie_drivers/K1: J1.2, U2.5 (DRAIN1)
/nixie_drivers/K2: J1.3, U2.6 (DRAIN2)
/nixie_drivers/K3: J1.4, U2.7 (DRAIN3)
/nixie_drivers/K4: J1.5, U2.14 (DRAIN4)
/nixie_drivers/K5: J1.6, U2.15 (DRAIN5)
/nixie_drivers/K6: J1.7, U2.16 (DRAIN6)
/nixie_drivers/K7: J1.8, U2.17 (DRAIN7)
/nixie_drivers/K8: J1.9, U3.4 (DRAIN0)
/nixie_drivers/K9: J1.10, U3.5 (DRAIN1)
/nixie_drivers/K10: J1.11, U3.6 (DRAIN2)
/nixie_drivers/K11: J1.12, U3.7 (DRAIN3)
/nixie_drivers/K12: J1.13, U3.14 (DRAIN4)
/nixie_drivers/K13: J1.14, U3.15 (DRAIN5)
/nixie_drivers/K14: J1.15, U3.16 (DRAIN6)
/nixie_drivers/K15: J1.16, U3.17 (DRAIN7)
/nixie_drivers/K16: J1.17, U4.4 (DRAIN0)
/nixie_drivers/K17: J1.18, U4.5 (DRAIN1)
/nixie_drivers/K18: J1.19, U4.6 (DRAIN2)
/nixie_drivers/K19: J1.20, U4.7 (DRAIN3)
/nixie_drivers/K20: J1.21, U4.14 (DRAIN4)
/nixie_drivers/K21: J1.22, U4.15 (DRAIN5)
/nixie_drivers/K22: J1.23, U4.16 (DRAIN6)
/nixie_drivers/K23: J1.24, U4.17 (DRAIN7)
/nixie_drivers/K24: J1.25, U5.4 (DRAIN0)
/nixie_drivers/K25: J1.26, U5.5 (DRAIN1)
/nixie_drivers/K26: J1.27, U5.6 (DRAIN2)
/nixie_drivers/K27: J1.28, U5.7 (DRAIN3)
/nixie_drivers/K28: J1.29, U5.14 (DRAIN4)
/nixie_drivers/K29: J1.30, U5.15 (DRAIN5)
/nixie_drivers/K30: J1.31, U5.16 (DRAIN6)
/nixie_drivers/K31: J1.32, U5.17 (DRAIN7)
/nixie_drivers/K32: J2.32, U6.4 (DRAIN0)
/nixie_drivers/K33: J2.31, U6.5 (DRAIN1)
/nixie_drivers/K34: J2.30, U6.6 (DRAIN2)
/nixie_drivers/K35: J2.29, U6.7 (DRAIN3)
/nixie_drivers/K36: J2.28, U6.14 (DRAIN4)
/nixie_drivers/K37: J2.27, U6.15 (DRAIN5)
/nixie_drivers/K38: J2.26, U6.16 (DRAIN6)
/nixie_drivers/K39: J2.25, U6.17 (DRAIN7)
/nixie_drivers/K40: J2.24, U7.4 (DRAIN0)
/nixie_drivers/K41: J2.23, U7.5 (DRAIN1)
/nixie_drivers/K42: J2.22, U7.6 (DRAIN2)
/nixie_drivers/K43: J2.21, U7.7 (DRAIN3)
/nixie_drivers/K44: J2.20, U7.14 (DRAIN4)
/nixie_drivers/K45: J2.19, U7.15 (DRAIN5)
/nixie_drivers/K46: J2.18, U7.16 (DRAIN6)
/nixie_drivers/K47: J2.17, U7.17 (DRAIN7)
/nixie_drivers/K48: J2.16, U8.4 (DRAIN0)
/nixie_drivers/K49: J2.15, U8.5 (DRAIN1)
/nixie_drivers/K50: J2.14, U8.6 (DRAIN2)
/nixie_drivers/K51: J2.13, U8.7 (DRAIN3)
/nixie_drivers/K52: J2.12, U8.14 (DRAIN4)
/nixie_drivers/K53: J2.11, U8.15 (DRAIN5)
/nixie_drivers/K54: J2.10, U8.16 (DRAIN6)
/nixie_drivers/K55: J2.9, U8.17 (DRAIN7)
/nixie_drivers/K56: J2.8, U9.4 (DRAIN0)
/nixie_drivers/K57: J2.7, U9.5 (DRAIN1)
/nixie_drivers/K58: J2.6, U9.6 (DRAIN2)
/nixie_drivers/K59: J2.5, U9.7 (DRAIN3)
/nixie_drivers/K60: J2.4, U9.14 (DRAIN4)
/nixie_drivers/K61: J2.3, U9.15 (DRAIN5)
/nixie_drivers/K62: J2.2, U9.16 (DRAIN6)
/nixie_drivers/K63: J2.1, U9.17 (DRAIN7)
/nixie_drivers/NX1: J1.34, R1.2
/nixie_drivers/NX2: J1.35, R2.2
/nixie_drivers/NX3: J1.36, R4.2
/nixie_drivers/NX4: J2.36, R5.2
/nixie_drivers/NX5: J2.35, R6.2
/nixie_drivers/NX6: J2.34, R7.2
ANODE: R3.1; also elsewhere on the board
NIXIE_HV: U1.4; also elsewhere on the board
NX_CLK: U2.13 (SRCK), U3.13 (SRCK), U4.13 (SRCK), U5.13 (SRCK), U6.13 (SRCK), U7.13 (SRCK), U8.13 (SRCK), U9.13 (SRCK); also elsewhere on the board
NX_G: U2.9 (~G), U3.9 (~G), U4.9 (~G), U5.9 (~G), U6.9 (~G), U7.9 (~G), U8.9 (~G), U9.9 (~G); also elsewhere on the board
NX_MOSI: U2.3 (SER_IN); also elsewhere on the board
NX_RCK: U2.12 (RCK), U3.12 (RCK), U4.12 (RCK), U5.12 (RCK), U6.12 (RCK), U7.12 (RCK), U8.12 (RCK), U9.12 (RCK); also elsewhere on the board
NX_SRCLR: U2.8 (~SRCLR), U3.8 (~SRCLR), U4.8 (~SRCLR), U5.8 (~SRCLR), U6.8 (~SRCLR), U7.8 (~SRCLR), U8.8 (~SRCLR), U9.8 (~SRCLR); also elsewhere on the board
unnamed: R1.1, R2.1, R4.1, R5.1, R6.1, R7.1, U1.3
unnamed: R3.2, U1.1
unnamed: U2.18 (SER_OUT), U3.3 (SER_IN)
unnamed: U3.18 (SER_OUT), U4.3 (SER_IN)
unnamed: U4.18 (SER_OUT), U5.3 (SER_IN)
unnamed: U5.18 (SER_OUT), U6.3 (SER_IN)
unnamed: U6.18 (SER_OUT), U7.3 (SER_IN)
unnamed: U7.18 (SER_OUT), U8.3 (SER_IN)
unnamed: U8.18 (SER_OUT), U9.3 (SER_IN)

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
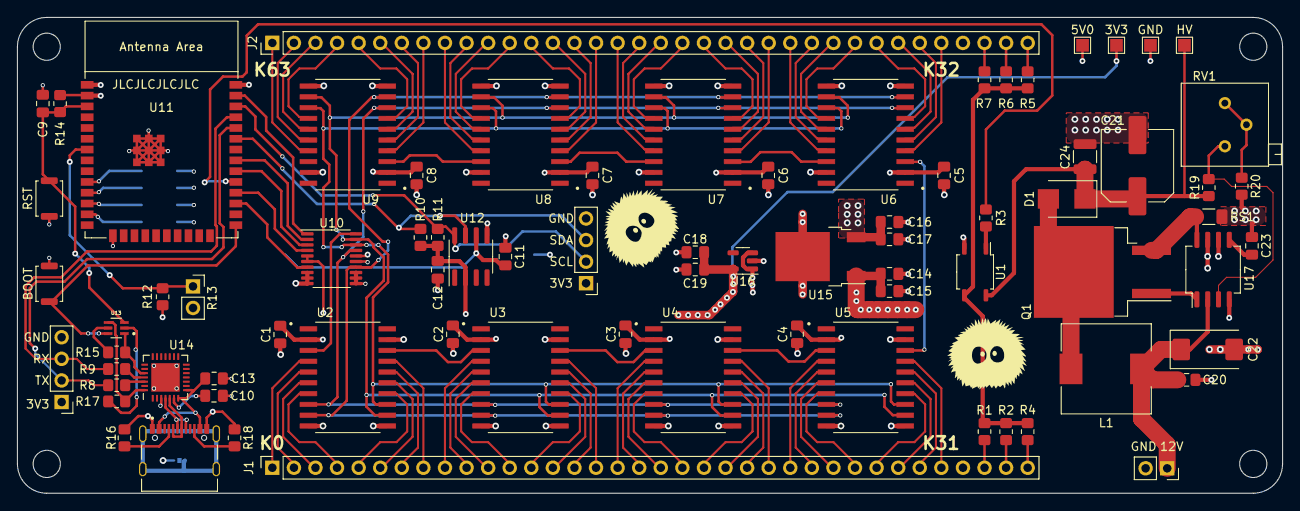
[picture p22: board nixie_controller.kicad_pcb from above]

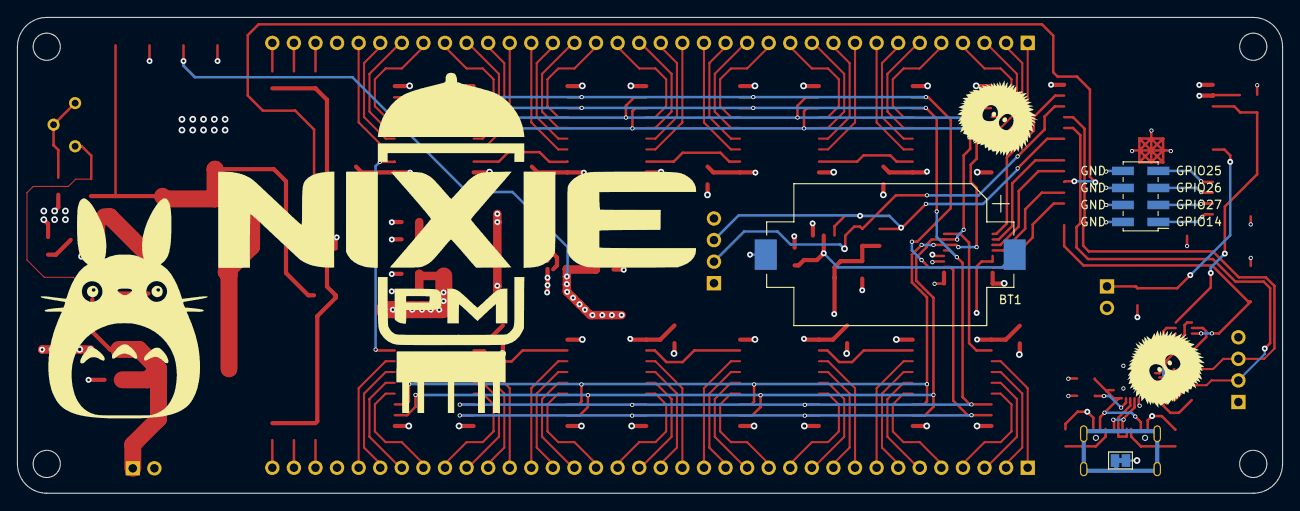
[picture p23: board nixie_controller.kicad_pcb from below]

Board: 4 copper layers, 148.9 x 56.0 mm, 85 parts (3 on the bottom side), 126 nets.

Other parts of the board:
J4#2: Conn_02x04_Odd_Even; PinHeader_2x04_P2.00mm_Vertical_SMD

Their connections:
/MCU/IO25: J4#2.7; also elsewhere on the board
/MCU/IO26: J4#2.5; also elsewhere on the board
