piotrpodlaski/NixieClockPCB/(commit log)

2023-03-22 remove unnecessary 3d
    [nixie_controller.sch]
2023-03-22 add bom
